d-b-w-gain/dincase/Dincase_Shelf.SLDASM

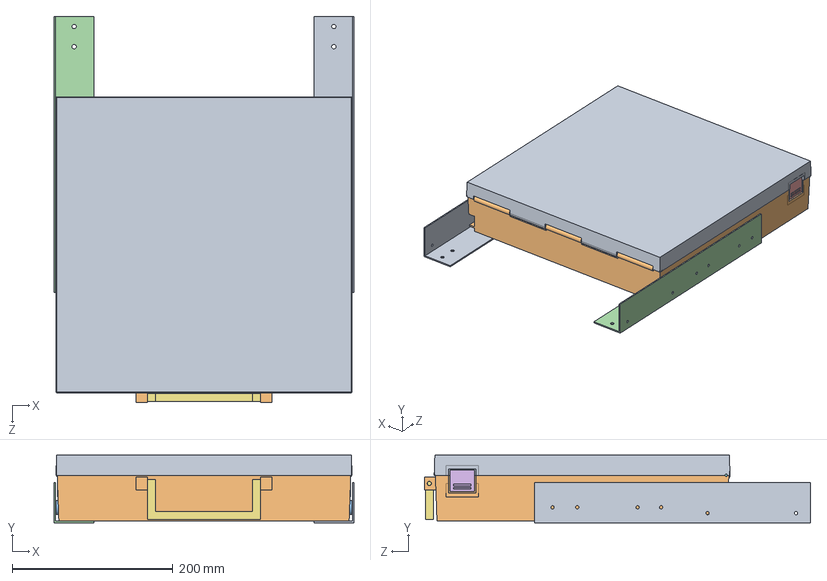
[picture p2: CAD file, 2026-10-20]
Dincase_Shelf.SLDASM
373.0 x 84.0 x 480.0 mm
RC_Base
RC_Lid
RC_HingeRod
RC_Handle
RC_Latch_R
RC_Latch_L
Shelf_Rail_L
Track_Roller x 4
Roller_Spacer x 4
Shelf_Rail_R
