d-b-w-gain/dincase/Dincase_Slide.SLDASM

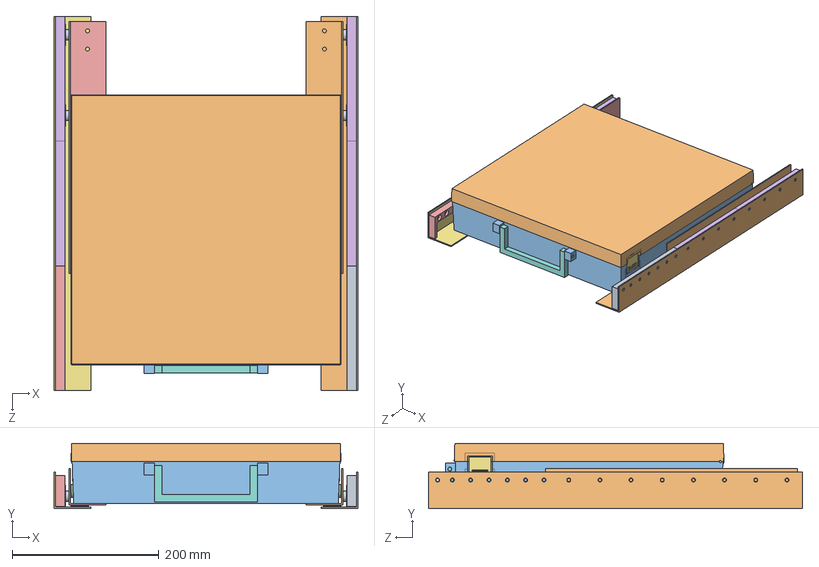
[picture p4: CAD file, 2026-10-20]
Dincase_Slide.SLDASM
414.0 x 89.0 x 510.0 mm
RC_Base
RC_Lid
RC_HingeRod
RC_Handle
RC_Latch_R
RC_Latch_L
Shelf_Rail_L
Track_Roller x 4
Roller_Spacer x 4
Shelf_Rail_R
Slide_Spacer x 4
Slide_Roller x 4
Slide_Rail_L
Slide_Keeper x 4
Slide_Keeper_Front_L
Landing_Pad x 2
Slide_Shoe x 2
Slide_Rail_R
Slide_Keeper_Front_R
