d-b-w-gain/dincase/RolaCase_Assembly.SLDASM

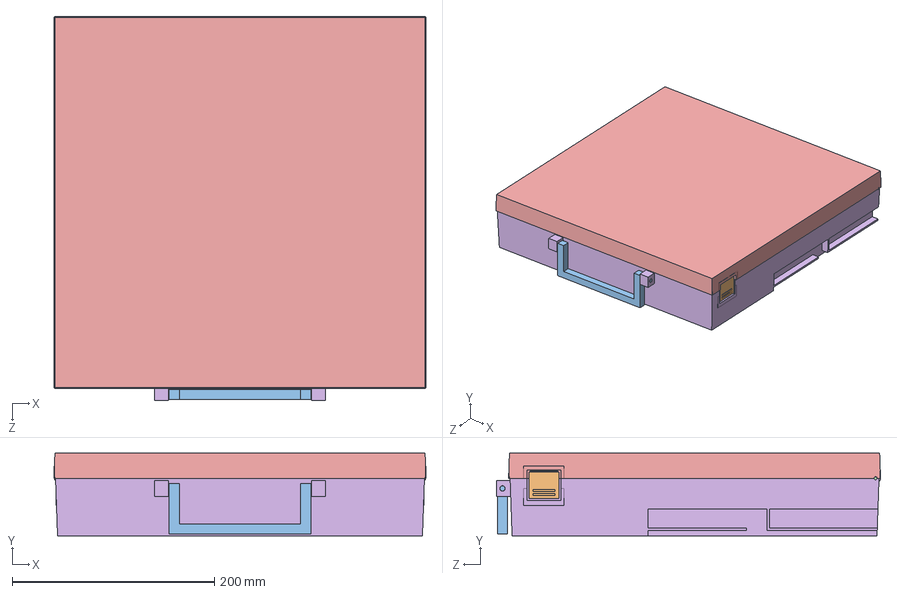
[picture p5: CAD file, 2026-10-19]
RolaCase_Assembly.SLDASM
368.0 x 82.0 x 380.0 mm
RC_Base
RC_Lid
RC_HingeRod
RC_Handle
RC_Latch_R
RC_Latch_L
