d-b-w-gain/dincase/RolaCase_AngleMount.SLDASM

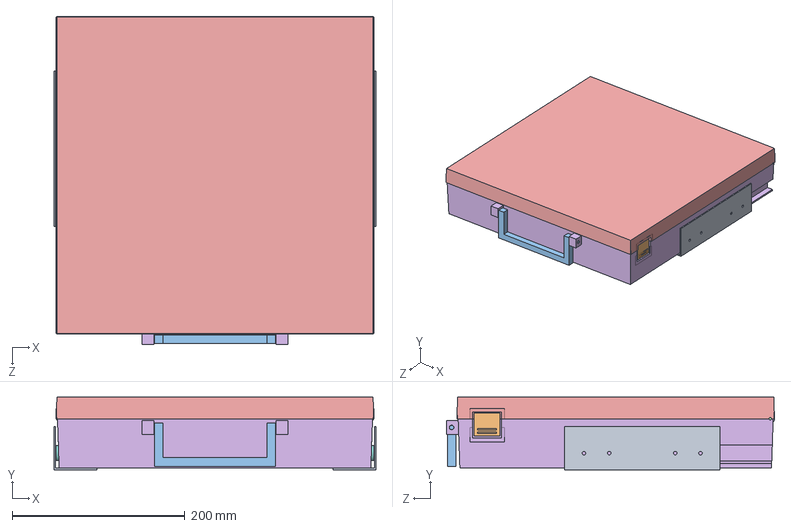
[picture p6: CAD file, 2026-10-19]
RolaCase_AngleMount.SLDASM
373.0 x 84.0 x 380.0 mm
Mount_Angle x 2
Track_Roller x 4
Roller_Spacer x 4
RC_Base
RC_Lid
RC_HingeRod
RC_Handle
RC_Latch_R
RC_Latch_L
