d-b-w-gain/dincase/parts/Slide_Shoe.SLDPRT

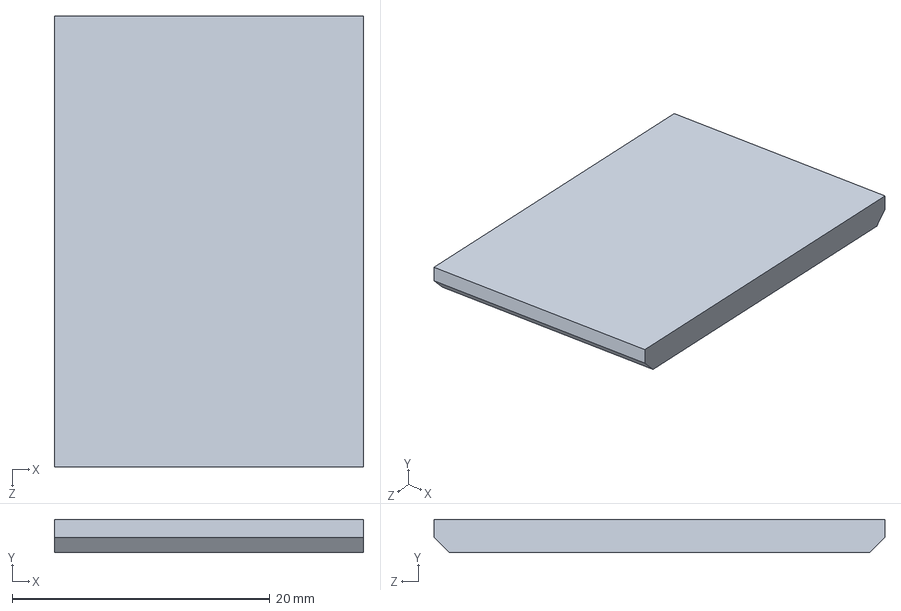
[picture p7: CAD file, 2026-10-20]
parts/Slide_Shoe.SLDPRT
24.0 x 2.60 x 35.0 mm
