d-b-w-gain/dincase/parts/Slide_Keeper_Front_R.SLDPRT

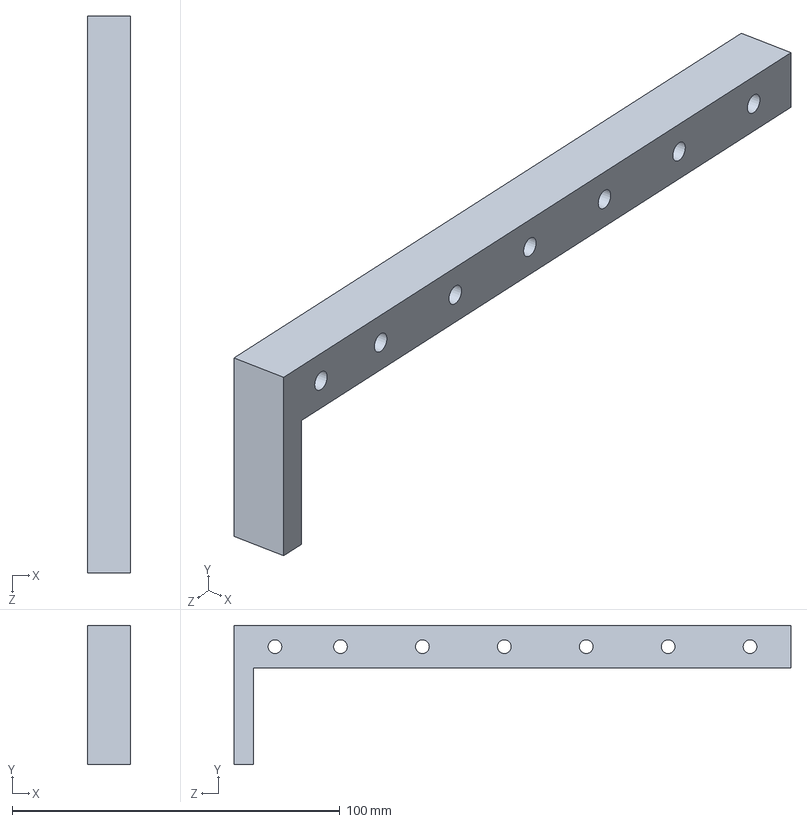
[picture p8: CAD file, 2026-10-20]
parts/Slide_Keeper_Front_R.SLDPRT
13.0 x 42.5 x 170.0 mm
