d-b-w-gain/dincase/parts/Slide_Roller.SLDPRT

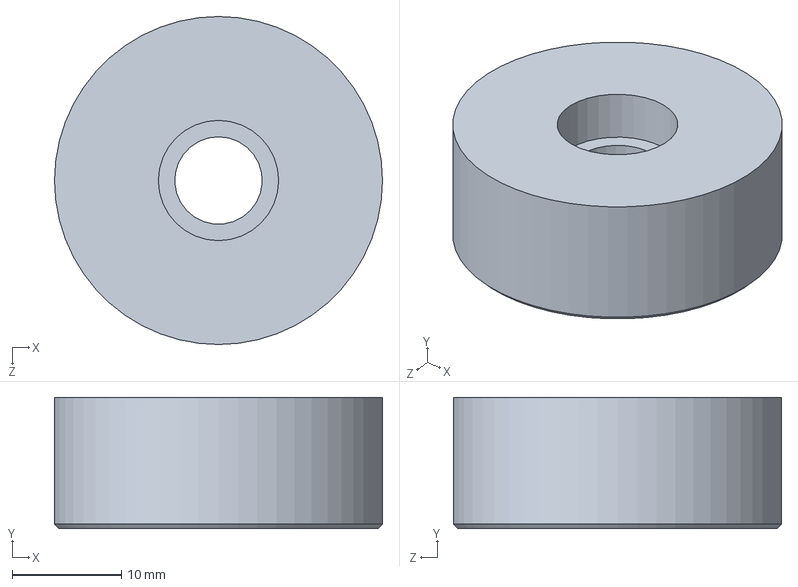
[picture p9: CAD file, 2026-10-20]
parts/Slide_Roller.SLDPRT
30.0 x 12.0 x 30.0 mm
