d-b-w-gain/dincase/parts/Shelf_Rail_L.SLDPRT

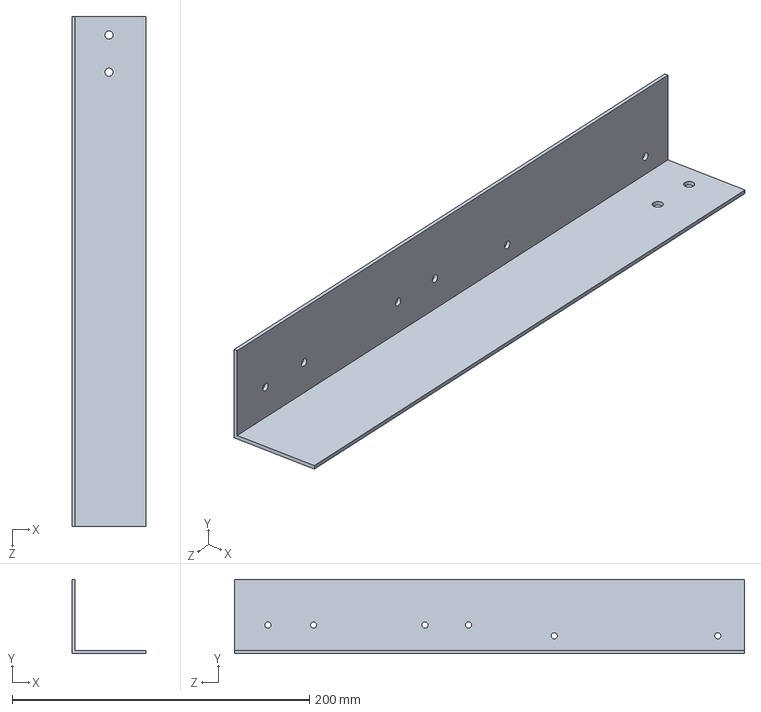
[picture p10: CAD file, 2026-10-20]
parts/Shelf_Rail_L.SLDPRT
50.0 x 50.0 x 343.2 mm
