d-b-w-gain/dincase/parts/Slide_Rail_L.SLDPRT

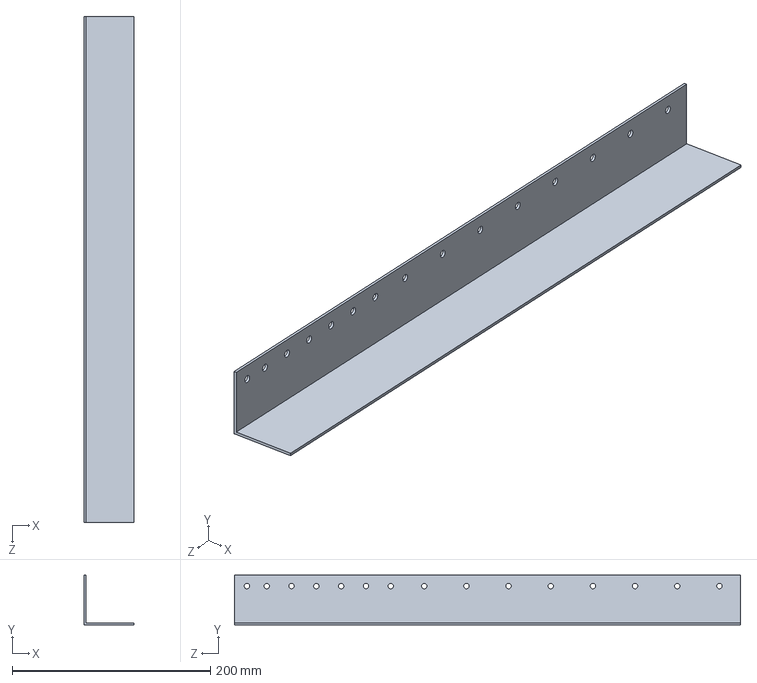
[picture p11: CAD file, 2026-10-20]
parts/Slide_Rail_L.SLDPRT
50.0 x 50.0 x 510.0 mm
