d-b-w-gain/dincase/parts/Slide_Spacer.SLDPRT

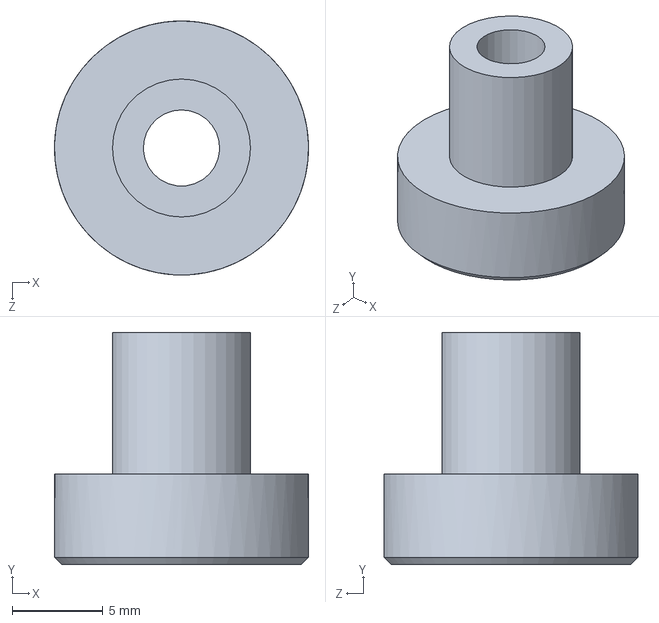
[picture p12: CAD file, 2026-10-20]
parts/Slide_Spacer.SLDPRT
14.0 x 12.8 x 14.0 mm
