d-b-w-gain/dincase/parts/Slide_Keeper.SLDPRT

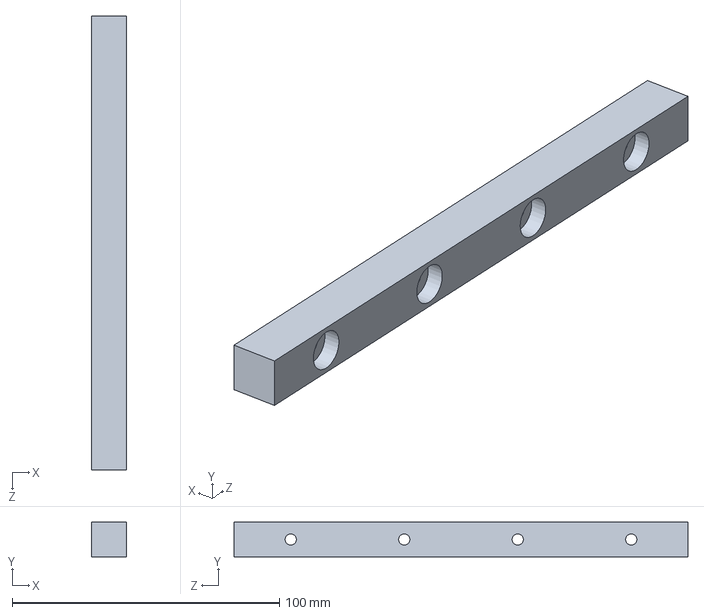
[picture p13: CAD file, 2026-10-20]
parts/Slide_Keeper.SLDPRT
13.0 x 13.0 x 170.0 mm
