d-b-w-gain/dincase/parts/Landing_Pad.SLDPRT

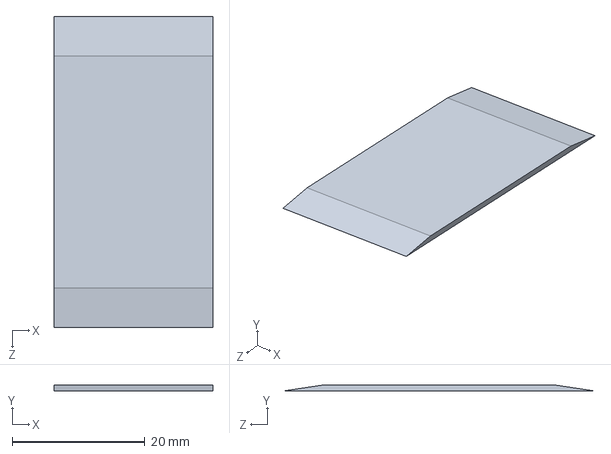
[picture p14: CAD file, 2026-10-20]
parts/Landing_Pad.SLDPRT
24.0 x 0.9 x 47.0 mm
