d-b-w-gain/dincase/parts/Trunk_550.SLDPRT

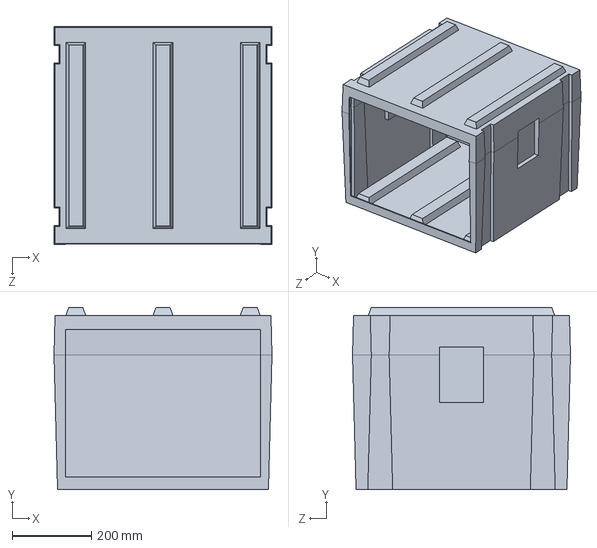
[picture p15: CAD file, 2026-10-19]
parts/Trunk_550.SLDPRT
550.0 x 460.0 x 550.0 mm
