d-b-w-gain/dincase/parts/RC_Lid.SLDPRT

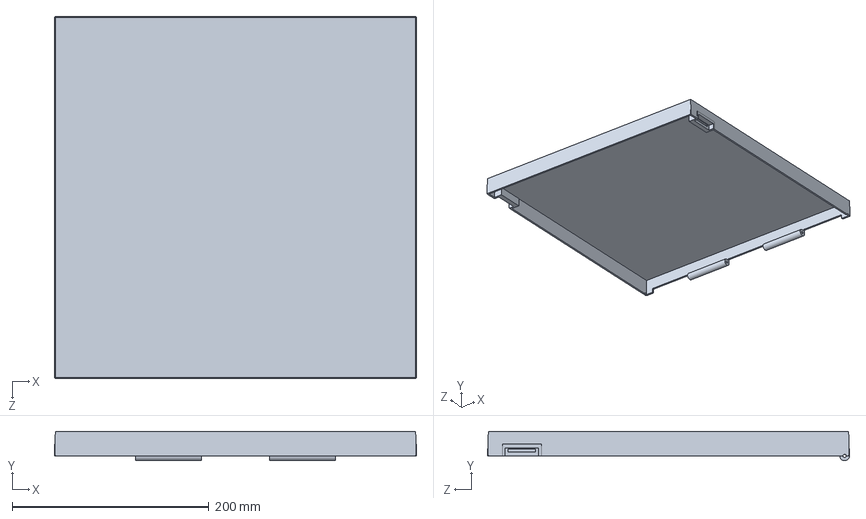
[picture p16: CAD file, 2026-10-19]
parts/RC_Lid.SLDPRT
368.0 x 30.0 x 368.0 mm
