d-b-w-gain/dincase/parts/RC_Latch_L.SLDPRT

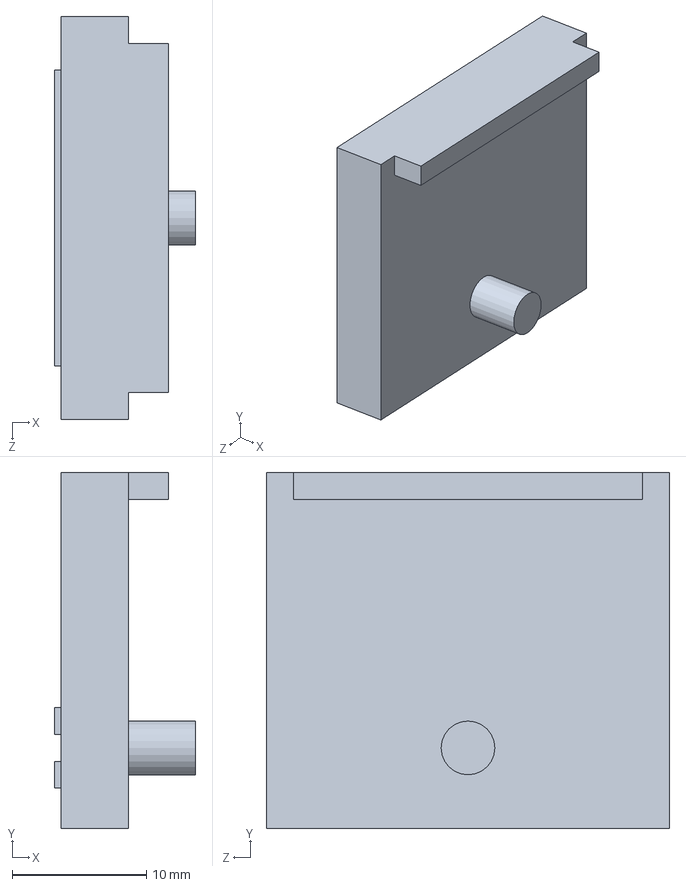
[picture p17: CAD file, 2026-10-19]
parts/RC_Latch_L.SLDPRT
10.5 x 26.5 x 30.0 mm
