d-b-w-gain/dincase/parts/RC_HingeRod.SLDPRT

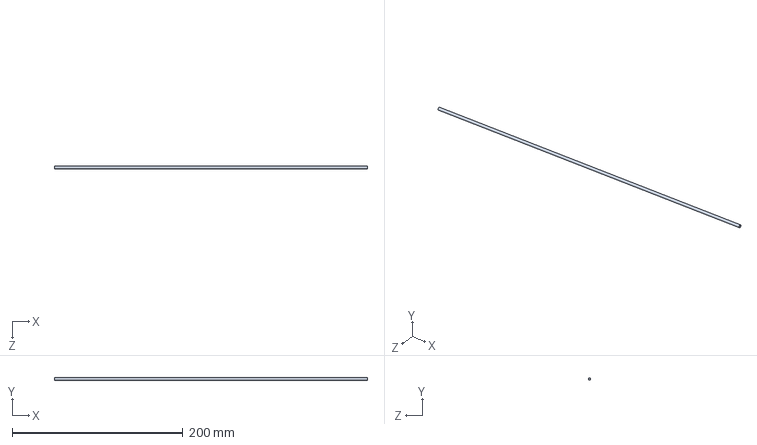
[picture p18: CAD file, 2026-10-19]
parts/RC_HingeRod.SLDPRT
367.0 x 3.00 x 3.00 mm
