d-b-w-gain/dincase/parts/RC_Base.SLDPRT

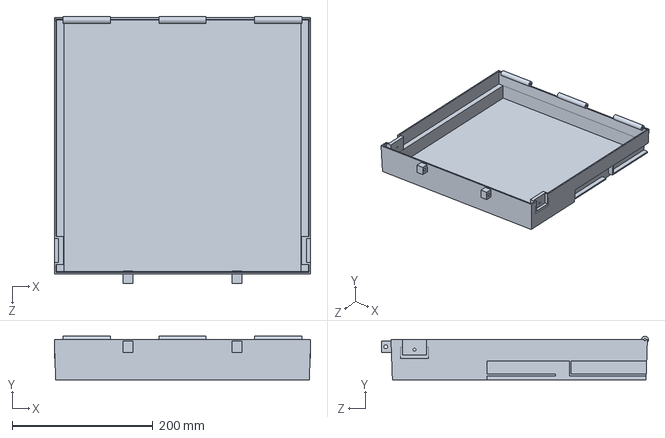
[picture p19: CAD file, 2026-10-19]
parts/RC_Base.SLDPRT
365.0 x 62.0 x 380.0 mm
