d-b-w-gain/dincase/parts/RC_Handle.SLDPRT

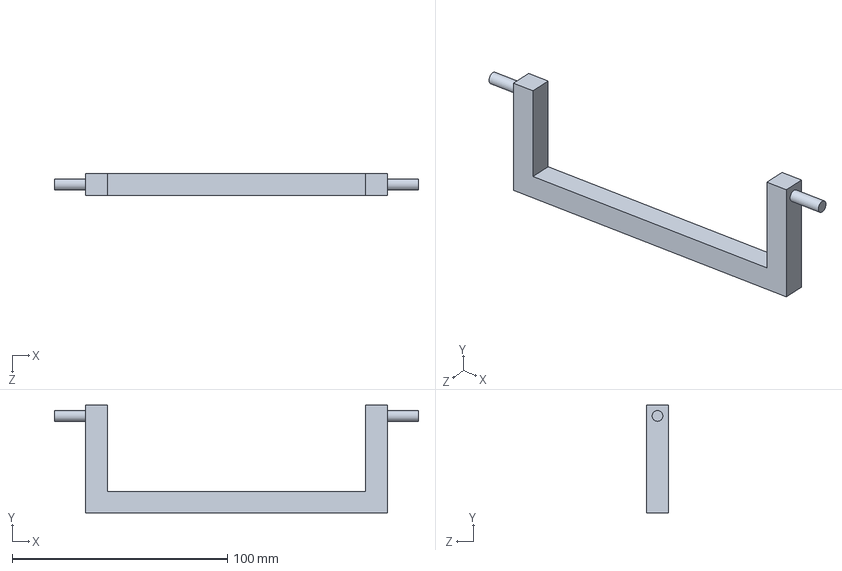
[picture p20: CAD file, 2026-10-19]
parts/RC_Handle.SLDPRT
169.0 x 50.0 x 10.00 mm
