d-b-w-gain/dincase/parts/Track_Roller.SLDPRT

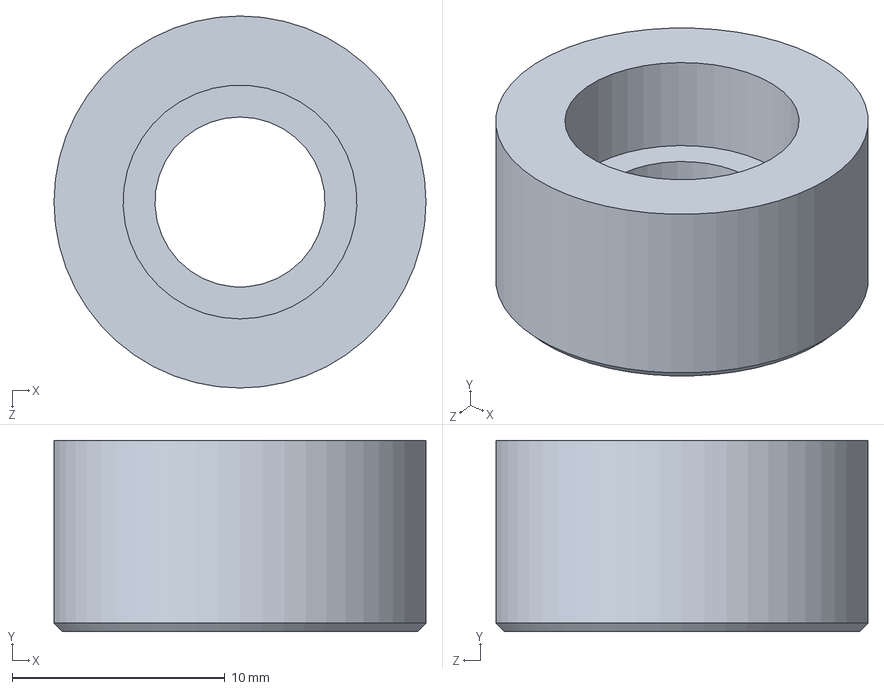
[picture p21: CAD file, 2026-10-19]
parts/Track_Roller.SLDPRT
17.5 x 9.00 x 17.5 mm
