d-b-w-gain/dincase/parts/Roller_Spacer.SLDPRT

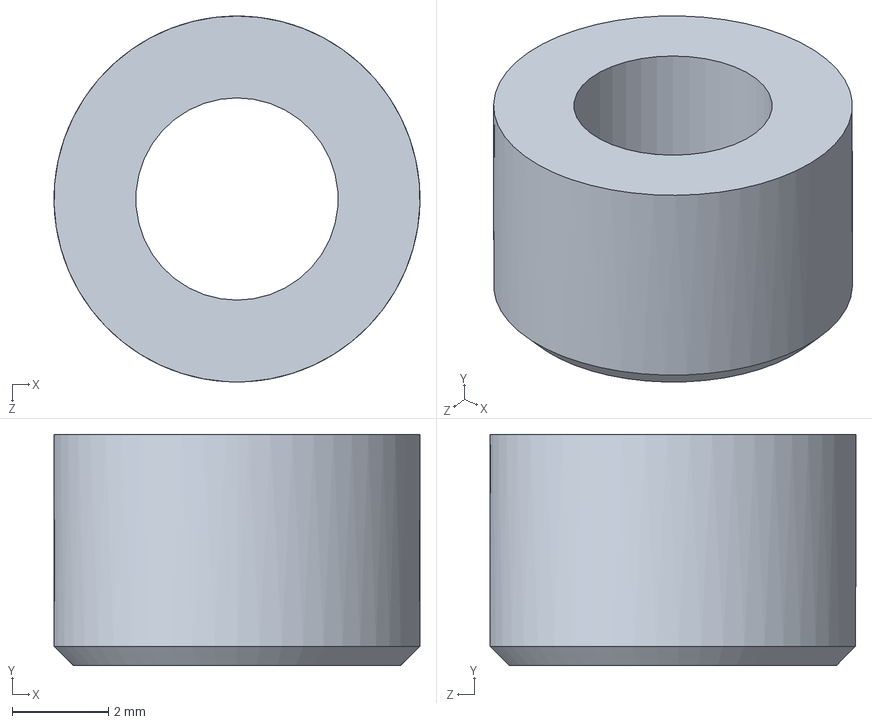
[picture p22: CAD file, 2026-10-19]
parts/Roller_Spacer.SLDPRT
7.60 x 4.80 x 7.60 mm
