d-b-w-gain/dincase/parts/Mount_Angle.SLDPRT

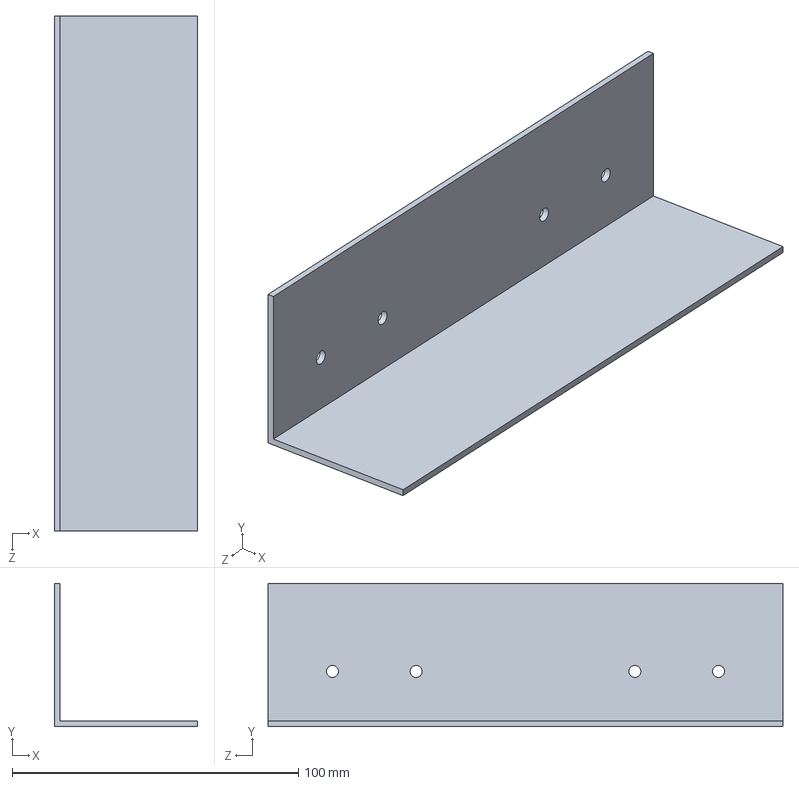
[picture p23: CAD file, 2026-10-19]
parts/Mount_Angle.SLDPRT
50.0 x 50.0 x 180.0 mm
