d-b-w-gain/dincase/parts/RC001_Case_v2.SLDPRT

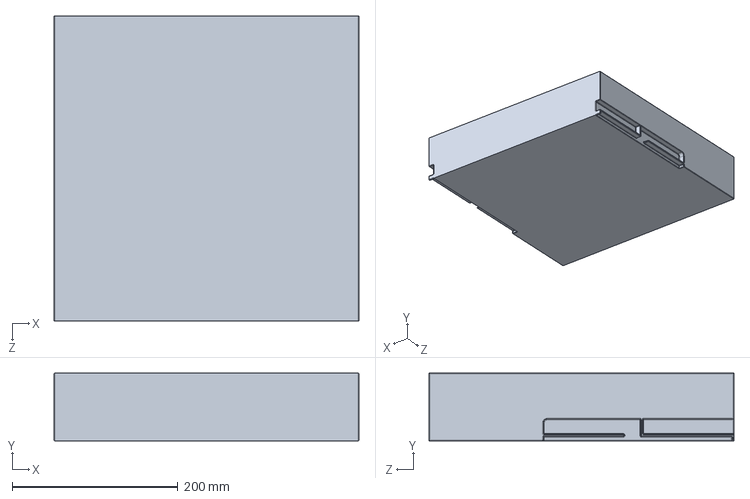
[picture p24: CAD file, 2026-10-19]
parts/RC001_Case_v2.SLDPRT
368.0 x 82.0 x 368.0 mm
