d-b-w-gain/dincase/(list of files, cad)

Other CAD files:
parts/Shelf_Rail_R.SLDPRT
parts/Slide_Keeper_Front_L.SLDPRT
parts/Slide_Rail_R.SLDPRT
parts/RC_Latch_R.SLDPRT
drawings/Mount_Angle.SLDDRW
drawings/Shelf_Rail.SLDDRW
drawings/Trunk_Measure.SLDDRW
parts/M5x12_Button.SLDPRT
stl/Landing_Pad.STL
stl/Roller_Spacer.STL
stl/Slide_Keeper.STL
stl/Slide_Keeper_Front_L.STL
stl/Slide_Keeper_Front_R.STL
stl/Slide_Roller.STL
stl/Slide_Shoe.STL
stl/Slide_Spacer.STL
stl/Track_Roller.STL
