d-b-w-gain/dincase/drawings/Trunk_Measure.PDF

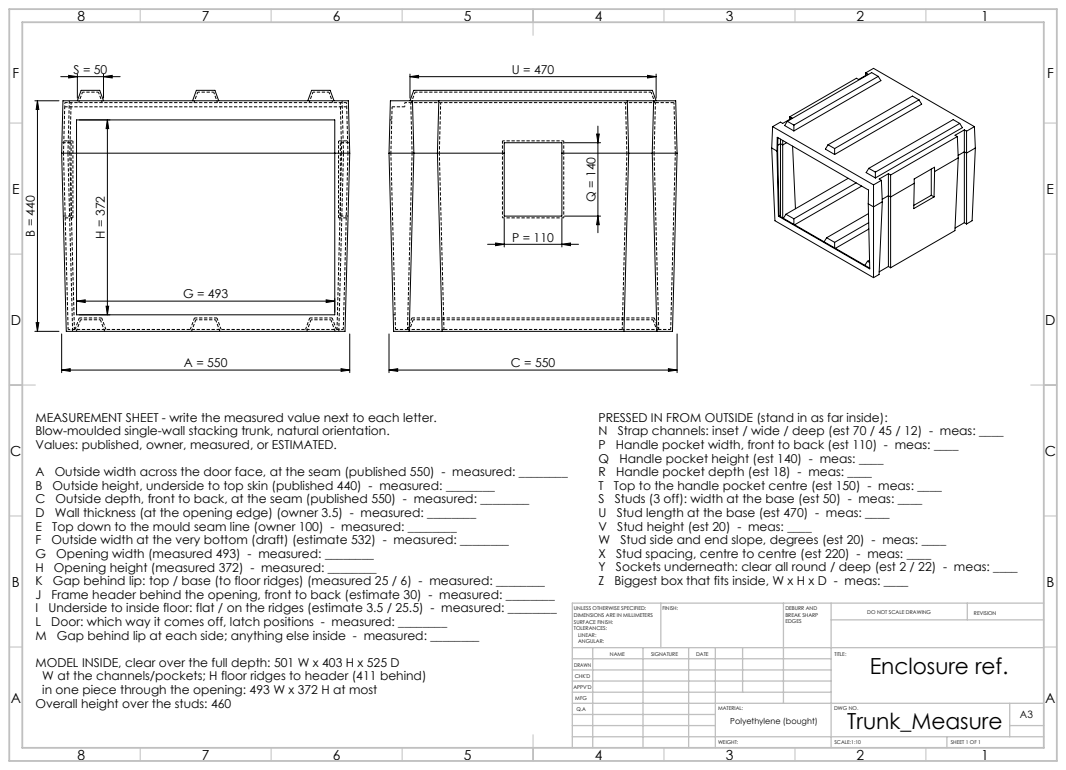
[picture p25: page 1]
FINISH:; DEBURR AND; BREAK SHARP; DO NOT SCALE DRAWING; REVISION; SCALE:1:10; SHEET 1 OF 1

MEASUREMENT SHEET - write the measured value next to each letter.
Blow-moulded single-wall stacking trunk, natural orientation.
Values: published, owner, measured, or ESTIMATED.
A Outside width across the door face, at the seam (published 550) - measured: ________
B Outside height, underside to top skin (published 440) - measured: ________
C Outside depth, front to back, at the seam (published 550) - measured: ________
D Wall thickness (at the opening edge) (owner 3.5) - measured: ________
E Top down to the mould seam line (owner 100) - measured: ________
F Outside width at the very bottom (draft) (estimate 532) - measured: ________
G Opening width (measured 493) - measured: ________
H Opening height (measured 372) - measured: ________
K Gap behind lip: top / base (to floor ridges) (measured 25 / 6) - measured: ________
J Frame header behind the opening, front to back (estimate 30) - measured: ________
I Underside to inside floor: flat / on the ridges (estimate 3.5 / 25.5) - measured: ________
L Door: which way it comes off, latch positions - measured: ________
M Gap behind lip at each side; anything else inside - measured: ________
MODEL INSIDE, clear over the full depth: 501 W x 403 H x 525 D
W at the channels/pockets; H floor ridges to header (411 behind)
in one piece through the opening: 493 W x 372 H at most
Overall height over the studs: 460

PRESSED IN FROM OUTSIDE (stand in as far inside):
N Strap channels: inset / wide / deep (est 70 / 45 / 12) - meas: ____
P Handle pocket width, front to back (est 110) - meas: ____
Q Handle pocket height (est 140) - meas: ____
R Handle pocket depth (est 18) - meas: ____
T Top to the handle pocket centre (est 150) - meas: ____
S Studs (3 off): width at the base (est 50) - meas: ____
U Stud length at the base (est 470) - meas: ____
V Stud height (est 20) - meas: ____
W Stud side and end slope, degrees (est 20) - meas: ____
X Stud spacing, centre to centre (est 220) - meas: ____
Y Sockets underneath: clear all round / deep (est 2 / 22) - meas: ____
Z Biggest box that fits inside, W x H x D - meas: ____

UNLESS OTHERWISE SPECIFIED:
DIMENSIONS ARE IN MILLIMETERS
SURFACE FINISH:
TOLERANCES:
LINEAR:
ANGULAR:

NAME | SIGNATURE | DATE | | | | TITLE: Enclosure ref.

DRAWN
CHK'D
APPV'D
MFG
Q.A | | | | MATERIAL: | DWG NO. Trunk_Measure | A3 Polyethylene (bought)
