d-b-w-gain/dincase/drawings/Shelf_Rail.PDF

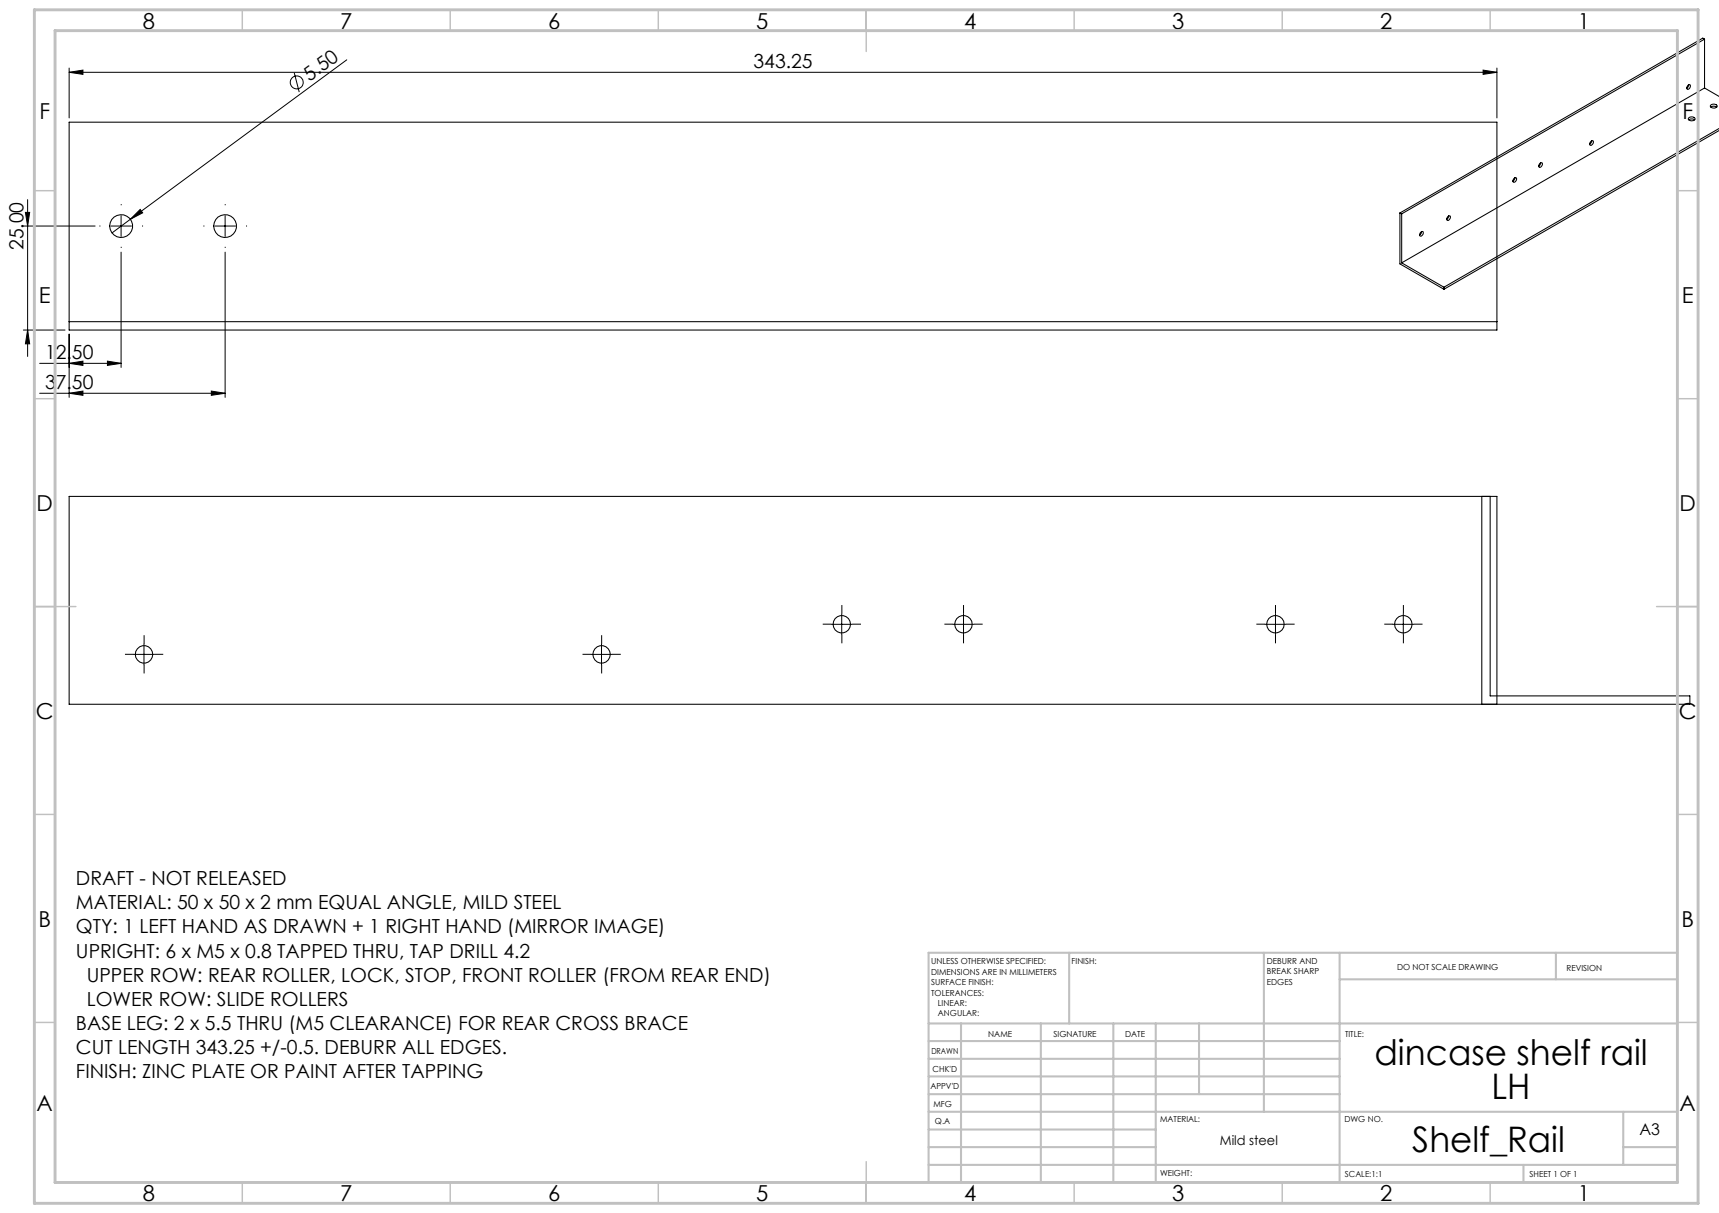
[picture p26: page 1]
FINISH:; DEBURR AND; BREAK SHARP; DO NOT SCALE DRAWING; REVISION; SCALE:1:1; SHEET 1 OF 1

DRAFT - NOT RELEASED
MATERIAL: 50 x 50 x 2 mm EQUAL ANGLE, MILD STEEL
QTY: 1 LEFT HAND AS DRAWN + 1 RIGHT HAND (MIRROR IMAGE)
UPRIGHT: 6 x M5 x 0.8 TAPPED THRU, TAP DRILL 4.2
UPPER ROW: REAR ROLLER, LOCK, STOP, FRONT ROLLER (FROM REAR END)
LOWER ROW: SLIDE ROLLERS
BASE LEG: 2 x 5.5 THRU (M5 CLEARANCE) FOR REAR CROSS BRACE
CUT LENGTH 343.25 +/-0.5. DEBURR ALL EDGES.
FINISH: ZINC PLATE OR PAINT AFTER TAPPING

UNLESS OTHERWISE SPECIFIED:
DIMENSIONS ARE IN MILLIMETERS
SURFACE FINISH:
TOLERANCES:
LINEAR:
ANGULAR:

NAME | SIGNATURE | DATE | | | | TITLE: dincase shelf rail LH

DRAWN
CHK'D
APPV'D
MFG
Q.A | | | | MATERIAL: | DWG NO. Shelf_Rail | A3 Mild steel
