d-b-w-gain/dincase/drawings/Mount_Angle.PDF

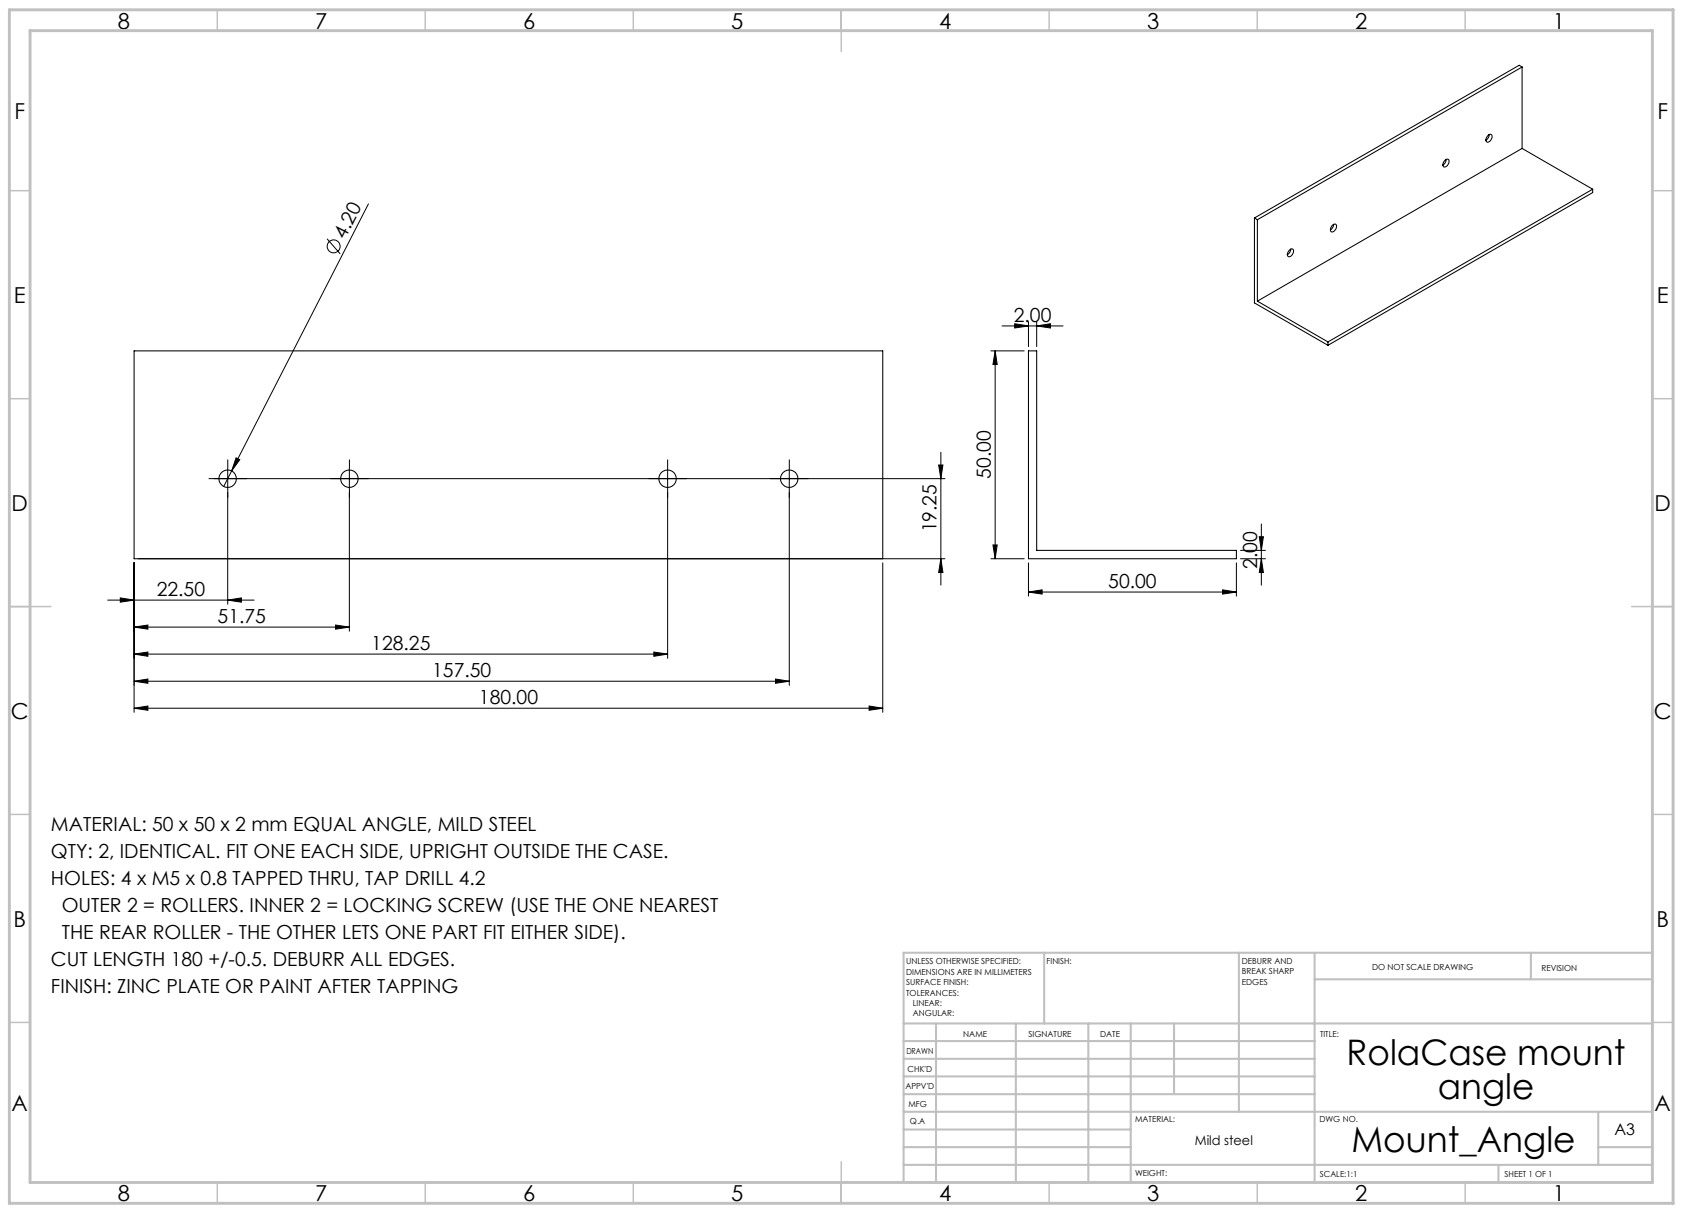
[picture p27: page 1]
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

MATERIAL: 50 x 50 x 2 mm EQUAL ANGLE, MILD STEEL
QTY: 2, IDENTICAL. FIT ONE EACH SIDE, UPRIGHT OUTSIDE THE CASE.
HOLES: 4 x M5 x 0.8 TAPPED THRU, TAP DRILL 4.2
OUTER 2 = ROLLERS. INNER 2 = LOCKING SCREW (USE THE ONE NEAREST
THE REAR ROLLER - THE OTHER LETS ONE PART FIT EITHER SIDE).
CUT LENGTH 180 +/-0.5. DEBURR ALL EDGES.
FINISH: ZINC PLATE OR PAINT AFTER TAPPING

UNLESS OTHERWISE SPECIFIED:
DIMENSIONS ARE IN MILLIMETERS
SURFACE FINISH:
TOLERANCES:
LINEAR:
ANGULAR:

NAME | SIGNATURE | DATE | | | | TITLE: RolaCase mount angle

DRAWN
CHK'D
APPV'D
MFG
Q.A | | | | MATERIAL: | DWG NO. Mount_Angle | A3 Mild steel
