d-b-w-gain/dincase/(commit log)

2026-10-19 dincase: DIN-rail style mount for carry parts cases
    Steel angles with 3D-printed rollers that lock a parts case (RolaCase-
    compatible side lock track) onto a rail: drop on, slide back, lock screw.
    SolidWorks builders driven by requirement files whose hash is each part's
    number (partnum); simplified case model for fit checks; fabrication
    drawing and printable STLs.
    [M5x12_Button.SLDPRT, Mount_Angle.SLDDRW, Mount_Angle.SLDPRT, RC001_Case_v2.SLDPRT, RC_Base.SLDPRT, RC_Handle.SLDPRT, RC_HingeRod.SLDPRT, RC_Latch_L.SLDPRT]
2026-10-19 Draft shelf rails: dincase angle extended past the case back
    Handed left/right rails (ZKM-91RV-KHZYH, KMP-CSMQ-45K0W) built from their
    own requirement files: same roller, lock-screw and case interface as the
    mounting angle, running 50 mm past the back of the case with two M5
    clearance holes in the base leg for a rear cross brace. Fit-check
    assembly with the case (no interferences) and an A3 fabrication drawing.
    Draft only - not released.
    [Dincase_Shelf.SLDASM, Shelf_Rail.SLDDRW, Shelf_Rail_L.SLDPRT, Shelf_Rail_R.SLDPRT]
2026-10-19 Case model: moulding draft on the base and lid walls
    The injection-moulded case is widest at the lid; the base sits 1.5 mm in
    at the seam and its walls draft about 2 degrees inwards towards the bottom,
    and the lid tapers towards its top (estimates from the photos, to be
    replaced by measured widths). Done as wedge cuts in build_case_assembly.py
    so the tracks and pockets keep their master positions. Handle bosses get
    a filler back to the drafted front wall. Angle mount and shelf assemblies
    re-linked; no interferences. Gap from the angle upright to the base wall
    is now about 2.3 mm at the top of the upright and 4 mm at the case bottom.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
    [Dincase_Shelf.SLDASM, RC_Base.SLDPRT, RC_Handle.SLDPRT, RC_HingeRod.SLDPRT, RC_Latch_L.SLDPRT, RC_Latch_R.SLDPRT, RC_Lid.SLDPRT, RolaCase_AngleMount.SLDASM]
2026-10-19 Case model: moulded inside, tracks and latches seated in the drafted wall
    The base and lid are now built like the moulding: inside walls drafted
    parallel to the outside (constant 2.5 mm wall, via drafted pocket cuts
    whose SolidWorks flags are probed on a test block first). The master's
    side tracks are filled and re-cut 10 mm deep from the drafted wall using
    the Sketch6 profile, so the full 2.5 mm lips are kept (track floor moves
    in 2.9 mm with the wall). Latch recesses, lid catches and the latches are
    seated relative to the drafted wall. Angle mount and shelf re-linked; no
    interferences.
    [Dincase_Shelf.SLDASM, RC_Base.SLDPRT, RC_Handle.SLDPRT, RC_HingeRod.SLDPRT, RC_Latch_L.SLDPRT, RC_Latch_R.SLDPRT, RC_Lid.SLDPRT, RolaCase_AngleMount.SLDASM]
2026-10-19 Stacking trunk reference: single-wall blow-moulded, natural orientation
    550 x 550 footprint, 440 high, door in the front 550 x 440 face. One
    3.5 mm wall, drafted both ways from a mould seam 100 mm below the top.
    Sloped studs on top with matching sockets underneath (ridges in the floor
    inside), strap channels and handle pockets in the side walls, and a frame
    header behind the door opening. The measurement sheet carries lettered
    dimensions and flags each value as published, owner, measured or estimate.
    [Trunk_550.SLDPRT, Trunk_Measure.SLDDRW]
2026-10-20 Drawer slide for the dincase shelf (draft), shelf rails rework
    Shelf rails gain a stop screw on the track line for a two-stage pull-out
    (the case rolls forward stop_travel_mm on its own rollers, then the rails
    run out on the slide), plus two low tapped holes for the slide rollers.
    New part numbers KGD-TC29-WE9V1 (LH) and GNV-W30Y-W0JQH (RH).
    build_slide.py adds the slide: fixed rails, slide rollers and spacers,
    printed keepers over the rollers (the front pair carries the end stop),
    a shoe and landing pad that take the shut drawer's weight off the
    keepers, their STLs, and shut and open fit-check assemblies.
    [Dincase_Shelf.SLDASM, Dincase_Slide.SLDASM, Dincase_Slide_Open.SLDASM, Landing_Pad.SLDPRT, Landing_Pad.STL, Shelf_Rail.SLDDRW, Shelf_Rail_L.SLDPRT, Shelf_Rail_R.SLDPRT]
2026-10-26 Port the dincase design to Tertius (Build123D)
    tertius-project/ is the whole design as a Tertius project, ported module
    by module from the SolidWorks builders: rollers, mounting angle and
    screw, case model, shelf rails, drawer slide and the stacking trunk, and
    the five assemblies, built from sketches, extrudes and cuts in the
    builders' axes (kit.py mirrors swkit.Kit) and turned to Z up in
    design.py. Parameters come from specs/*.yaml via tools/sync_specs.py,
    which computes the part numbers with partnum; released numbers match.
    Checked on the server: printed parts within 0.25% of the SolidWorks
    STLs by volume, same sizes; steel parts match hand-calculated volumes;
    the builders' asserts and pl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
2026-10-26 README: photo of a case on its mount
